suryathanush/GanFET-Buck-Converter/Frimware/images/Status Command.png

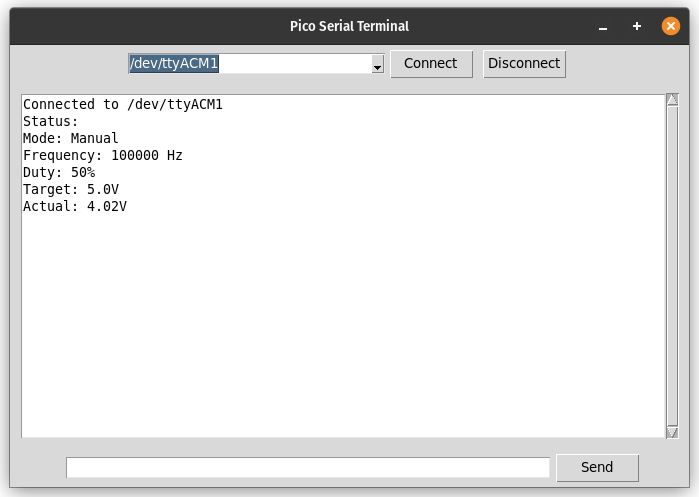
Frimware/images/Status Command.png
