suryathanush/GanFET-Buck-Converter/PCB/snor026/LMG1210 EVM files/HVP012A(001)_BOM.xls

Filename: | HVP012A(001)_BOM.xls
Variant: | 001
Generated: | 6/4/2018 12:50:12 PM
 |  | LMG1210EVM-012
Designator | Quantity | Value | Description | PackageReference | PartNumber | Manufacturer | Alternate PartNumber | Alternate Manufacturer
!PCB1 | 1 |  | Printed Circuit Board |  | HVP012 | Any
C1, C11 | 2 | 10uF | CAP, CERM, 10 uF, 25 V, +/- 10%, X7R, 1206 | 1206 | 885012208069 | Wurth Elektronik
C2, C14 | 2 | 0.47uF | Feedthru Capacitor, 0.47uF, 6.3V, SMD | 0603 | YFF18PW0J474M | TDK
C3, C19 | 2 | 1uF | CAP, CERM, 1 uF, 250 V, +/- 10%, X7R, 2220 | 2220 | GRM55DR72E105KW01L | MuRata
C4, C5, C12 | 3 | 0.022uF | CAP, CERM, 0.022 uF, 250 V, +/- 10%, X7R, 0805 | 0805 | QMK212B7223KG-T | Taiyo Yuden
C7, C10, C18, C21 | 4 | 0.22uF | CAP, CERM, 0.22 uF, 250 V, +/- 10%, X7R, 1210 | 1210 | GRM32DR72E224KW01L | MuRata
C13 | 1 | 0.1uF | CAP, CERM, 0.1 uF, 25 V, +/- 10%, X7R, 0603 | 0603 | GRM188R71E104KA01D | MuRata
D1 | 1 | 100V | Diode, Schottky, 100 V, 0.25 A, SOD-323F | SOD-323F | BAT46WJ,115 | Nexperia
D2, D3 | 2 | Green | LED, Green, SMD | LED_0805 | LTST-C170KGKT | Lite-On
H1, H2, H3, H4 | 4 |  | Machine Screw, Round, #4-40 x 1/4, Nylon, Philips panhead | Screw | NY PMS 440 0025 PH | B&F Fastener Supply
H5, H6, H7, H8 | 4 |  | Standoff, Hex, 0.5"L #4-40 Nylon | Standoff | 1902C | Keystone
J1 | 1 |  | Terminal Block, 2.54mm, 2x1, Brass, TH | Terminal Block, 2.54mm, 2-pole, Brass, TH | OSTVN02A150 | On-Shore Technology
J2, J5 | 2 |  | Terminal Block, 2x1, 5.08mm, TH | 10.16x15.2x9mm | 282841-2 | TE Connectivity
J3, J6, J7 | 3 |  | Header, 2.54 mm, 2x1, Gold, TH | Header, 2.54 mm, 2x1, TH | GBC02SAAN | Sullins Connector Solutions
J4 | 1 |  | Header, 100mil, 4x1, Tin, TH | Header, 4x1, 100mil, TH | 5-146278-4 | TE Connectivity
L2 | 1 | 4.7uH | Inductor, Shielded, Composite, 4.7 uH, 10.5 A, 0.00889 ohm, SMD | 8.1 x 8 x 8.6mm | XAL8080-472ME | Coilcraft
Q1, Q2 | 2 | 100V | MOSFET, N-CH, 100 V, 36 A, 4.105x1.632mm | 4.105x1.632mm | EPC2001C | EPC |  | None
R2, R4 | 2 | 0 | RES, 0, 5%, 0.1 W, AEC-Q200 Grade 0, 0402 | 0402 | ERJ-2GE0R00X | Panasonic
R3, R10 | 2 | 0 | RES, 0, 5%, 0.05 W, AEC-Q200 Grade 1, 0201 | 0201 | ERJ-1GE0R00C | Panasonic
R6, R9 | 2 | 20.0k | RES, 20.0 k, 1%, 0.063 W, AEC-Q200 Grade 0, 0402 | 0402 | CRCW040220K0FKED | Vishay-Dale
R7 | 1 | 0.005 | RES, 0.005, 1%, 1 W, 0612 | 0612 | PRL1632-R005-F-T1 | Susumu Co Ltd
R11, R12 | 2 | 20.0k | RES, 20.0 k, 1%, 0.05 W, 0201 | 0201 | CRCW020120K0FKED | Vishay-Dale
R13, R14 | 2 | 1M | TRIMMER 1M OHM 0.25W SMD | 3.5x5.3x4.8mm | 3224X-1-105E | Bourns
R15 | 1 | 1.0k | RES, 1.0 k, 5%, 0.1 W, AEC-Q200 Grade 0, 0603 | 0603 | CRCW06031K00JNEA | Vishay-Dale
R16 | 1 | 100k | RES, 100 k, 5%, 0.25 W, AEC-Q200 Grade 0, 1206 | 1206 | CRCW1206100KJNEA | Vishay-Dale
SH-J1 | 1 | 1x2 | Shunt, 100mil, Gold plated, Black | Shunt | SNT-100-BK-G | Samtec | 969102-0000-DA | 3M
TP1 | 1 |  | Test Point, Compact, Yellow, TH | Yellow Compact Testpoint | 5009 | Keystone
TP2 | 1 |  | Test Point, Compact, Red, TH | Red Compact Testpoint | 5005 | Keystone
TP4, TP7, TP13 | 3 |  | Test Point, Compact, Black, TH | Black Compact Testpoint | 5006 | Keystone
TP6, TP10 | 2 |  | Test Point, Miniature, Red, TH | Red Miniature Testpoint | 5000 | Keystone
U1 | 1 |  | Advanced eGaN FET 300V Half-bridge Drive, RVR0019A (WQFN-19) | RVR0019A | LMG1210RVR | Texas Instruments |  | Texas Instruments
U2 | 1 |  | Dual Schmitt-Trigger Buffer, DBV0006A, LARGE T&R | DBV0006A |  | Texas Instruments
C6 | 0 | 22uF | CAP, AL, 22 uF, 20 V, +/- 20%, 0.06 ohm, SMD | F60 | APXH200ARA220MF60G | Chemi-Con
C15, C16 | 0 | 10pF | CAP, CERM, 10 pF, 50 V, +/- 5%, C0G/NP0, 0402 | 0402 | 500R07S100JV4T | Johanson Technology
C17 | 0 | 47uF | CAP, AL, 47 uF, 20 V, +/- 20%, 0.045 ohm, SMD | H70 | APXH200ARA470MH70G | Chemi-Con
C20 | 0 | 0.22uF | CAP, CERM, 0.22 uF, 250 V, +/- 10%, X7R, 1210 | 1210 | GRM32DR72E224KW01L | MuRata
FID1, FID2, FID3, FID4, FID5, FID6 | 0 |  | Fiducial mark. There is nothing to buy or mount. | N/A | N/A | N/A
R1, R8 | 0 | 0 | RES, 0, 5%, 0.1 W, AEC-Q200 Grade 0, 0402 | 0402 | ERJ-2GE0R00X | Panasonic
SH-J1 | 1 |  | Shunt, 100mil, Gold plated, Black | Shunt | SNT-100-BK-G | Samtec
 |  | Notes:
 |  | Unless otherwise noted in the Alternate PartNumber and/or Alternate Manufacturer columns, all parts may be substituted with equivalents.
