suryathanush/GanFET-Buck-Converter/PCB/LIB_YFF18PW0J474MT0H0N/YFF18PW0J474MT0H0N.stp

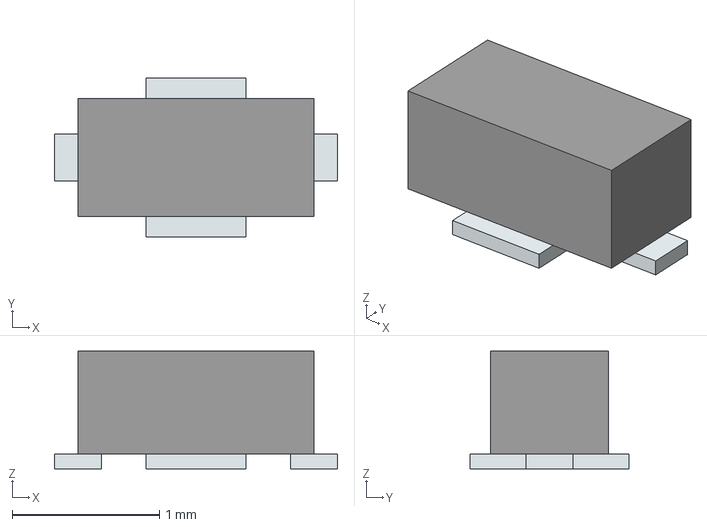
[picture p7: CAD file, 2025-04-16]
PCB/LIB_YFF18PW0J474MT0H0N/YFF18PW0J474MT0H0N.stp
1.92 x 1.08 x 0.8 mm
Pins
