suryathanush/GanFET-Buck-Converter/PCB/snor026/LMG1210 EVM files/HVP012A(001)_Sch.PDF

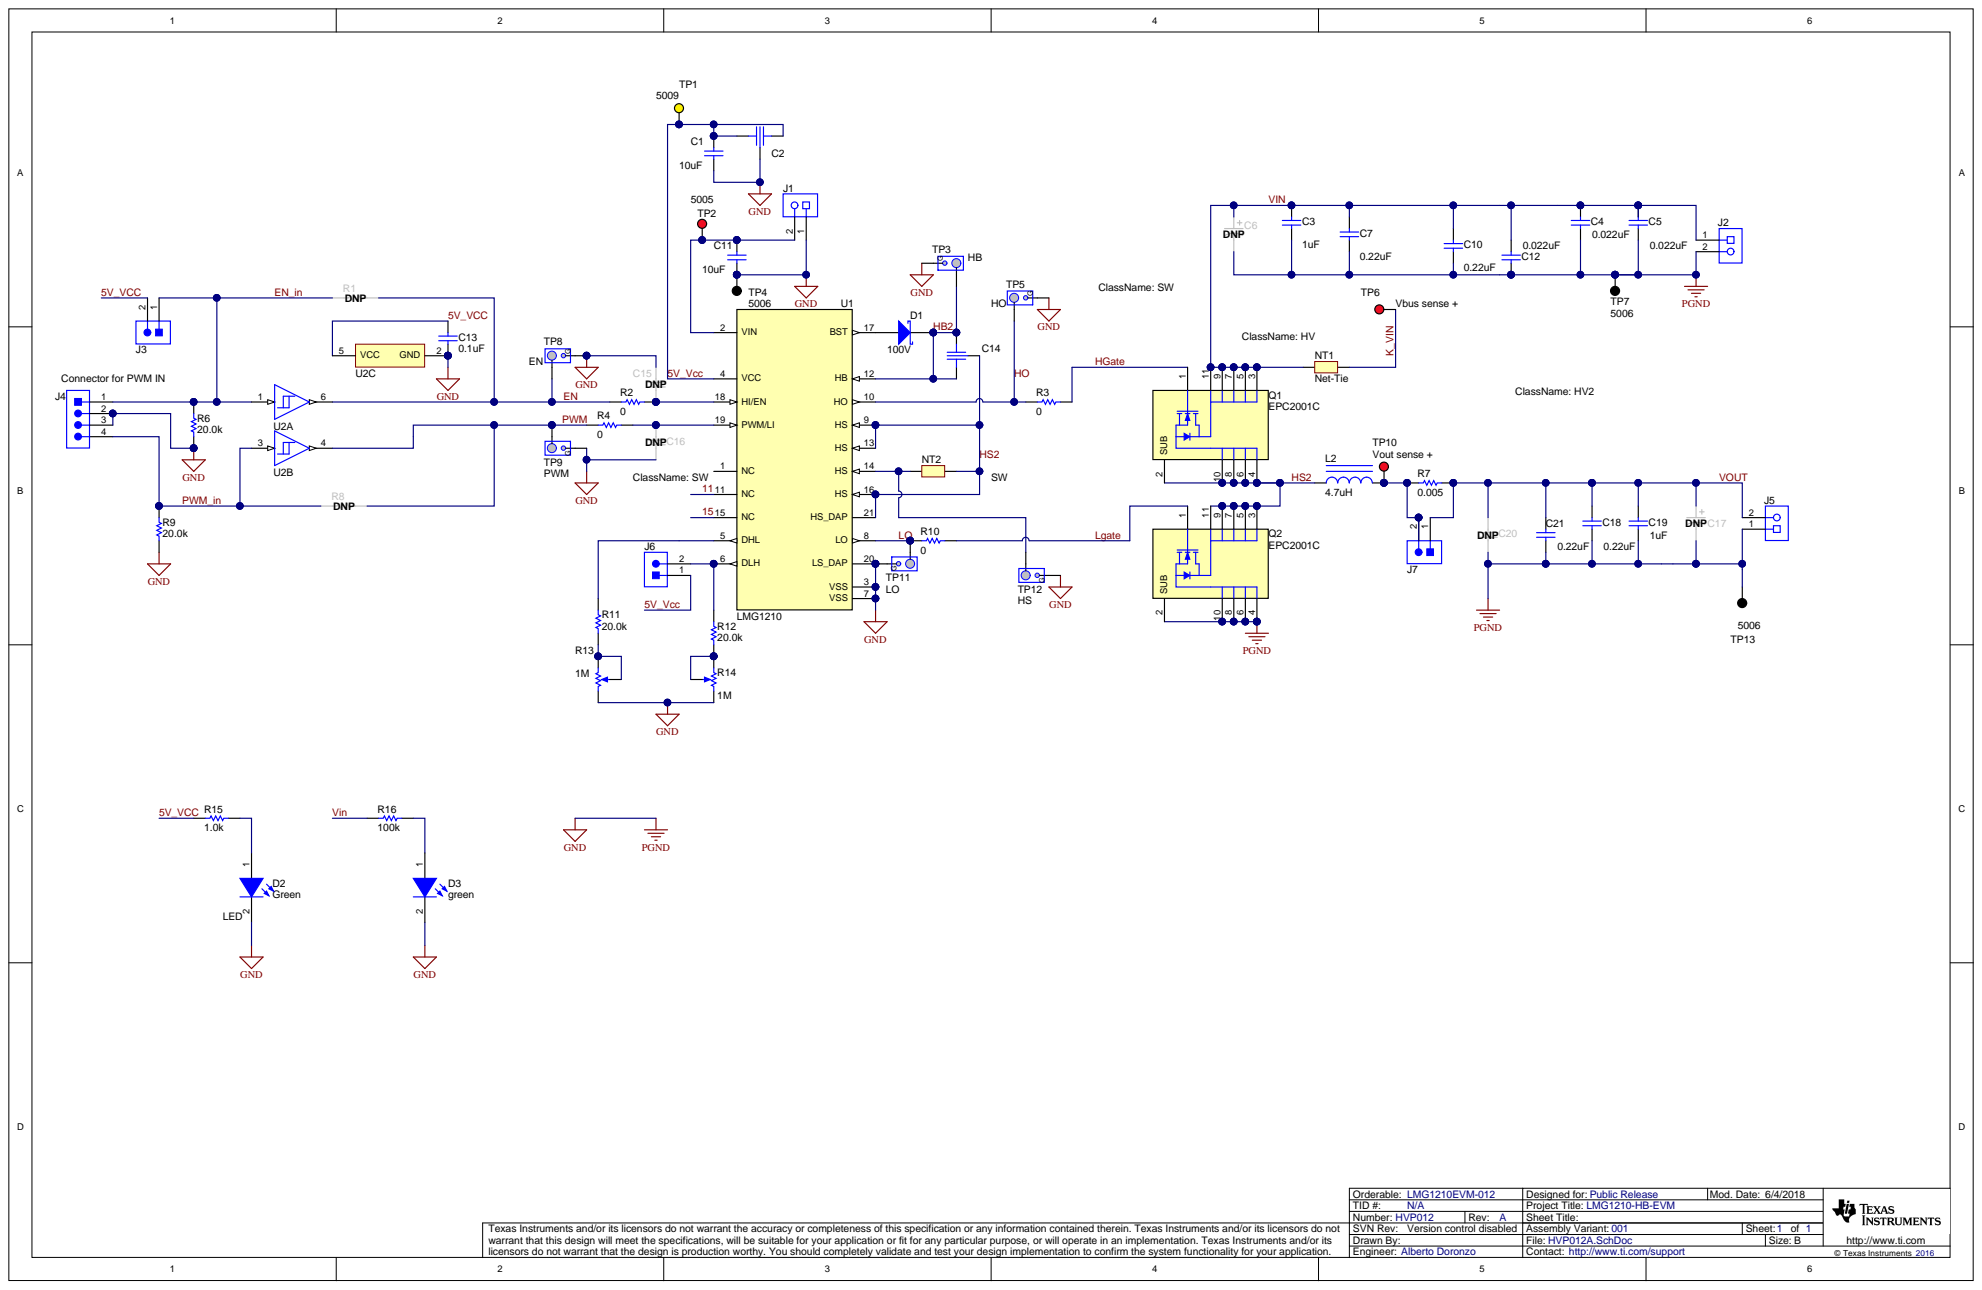
[picture p11: page 1]

C1 10uF 5005 TP2 5V_Vcc

Connector for PWM IN

Orderable: LMG1210EVM-012 | Designed for: Public Release | Mod. Date: 6/4/2018 | http://www.ti.com
TID #: N/A | Project Title: LMG1210-HB-EVM
Number: HVP012 | Rev: A | Sheet Title:
SVN Rev: Version control disabled | Assembly Variant: 001 | Sheet: 1 of 1
Drawn By: | File: HVP012A.SchDoc | Size: B

Texas Instruments and/or its licensors do not warrant the accuracy or completeness of this specification or any information contained therein. Texas Instruments and/or its licensors do not
warrant that this design will meet the specifications, will be suitable for your application or fit for any particular purpose, or will operate in an implementation. Texas Instruments and/or its
licensors do not warrant that the design is production worthy. You should completely validate and test your design implementation to confirm the system functionality for your application.

Contact: http://www.ti.com/support © Texas Instruments 2016

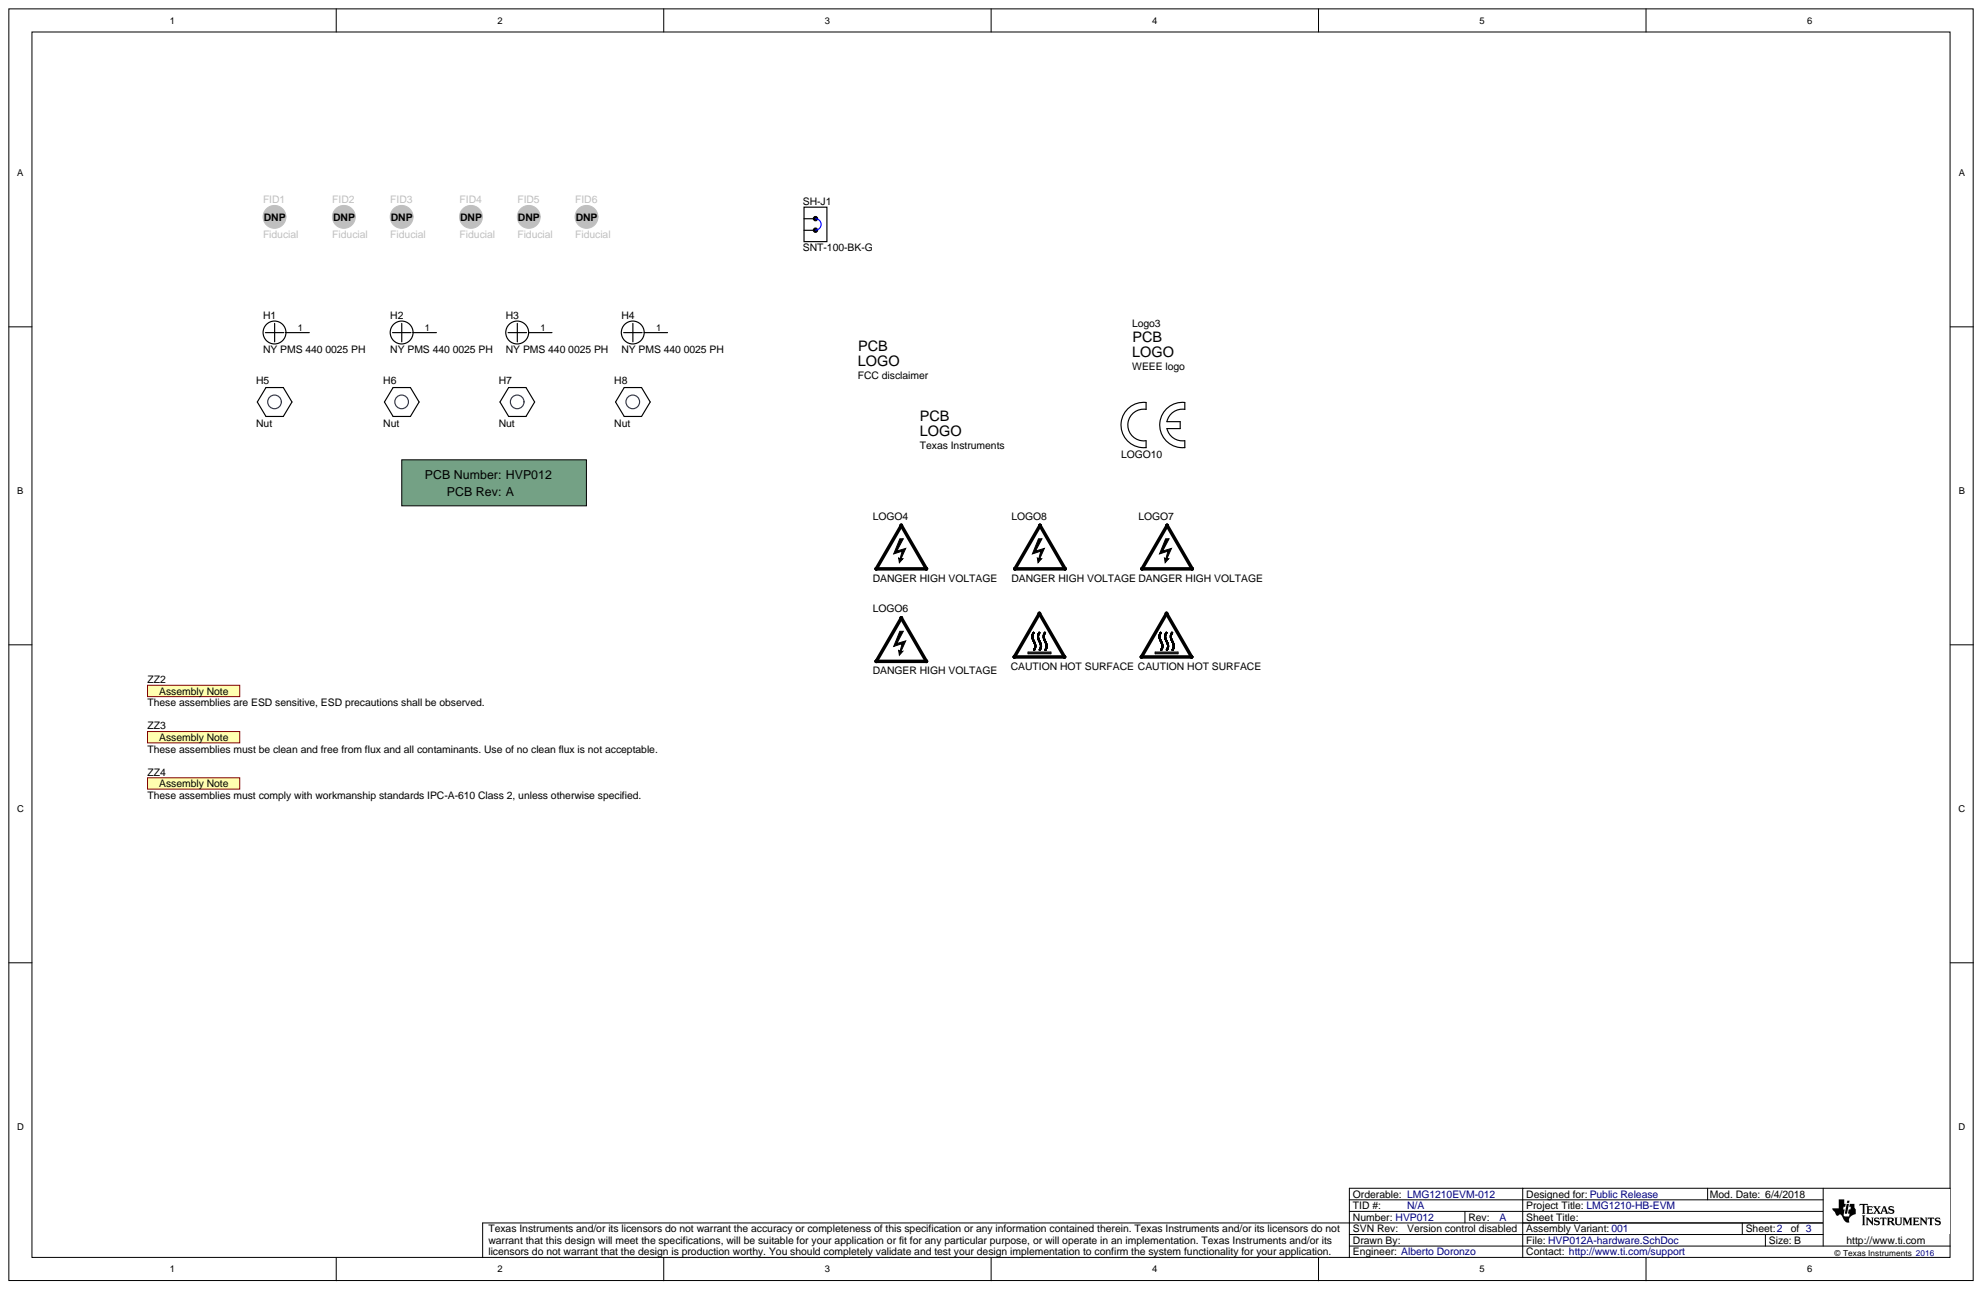
[picture p12: page 2]

Assembly Note
These assemblies are ESD sensitive, ESD precautions shall be observed.

These assemblies must be clean and free from flux and all contaminants. Use of no clean flux is not acceptable.

These assemblies must comply with workmanship standards IPC-A-610 Class 2, unless otherwise specified.

Orderable: LMG1210EVM-012 | Designed for: Public Release | Mod. Date: 6/4/2018 | http://www.ti.com
TID #: N/A | Project Title: LMG1210-HB-EVM
Number: HVP012 | Rev: A | Sheet Title:
SVN Rev: Version control disabled | Assembly Variant: 001 | Sheet: 2 of 3
Drawn By: | File: HVP012A-hardware.SchDoc | Size: B

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

Contact: http://www.ti.com/support © Texas Instruments 2016
