suryathanush/GanFET-Buck-Converter/PCB/Schematic_21_04_2025.pdf

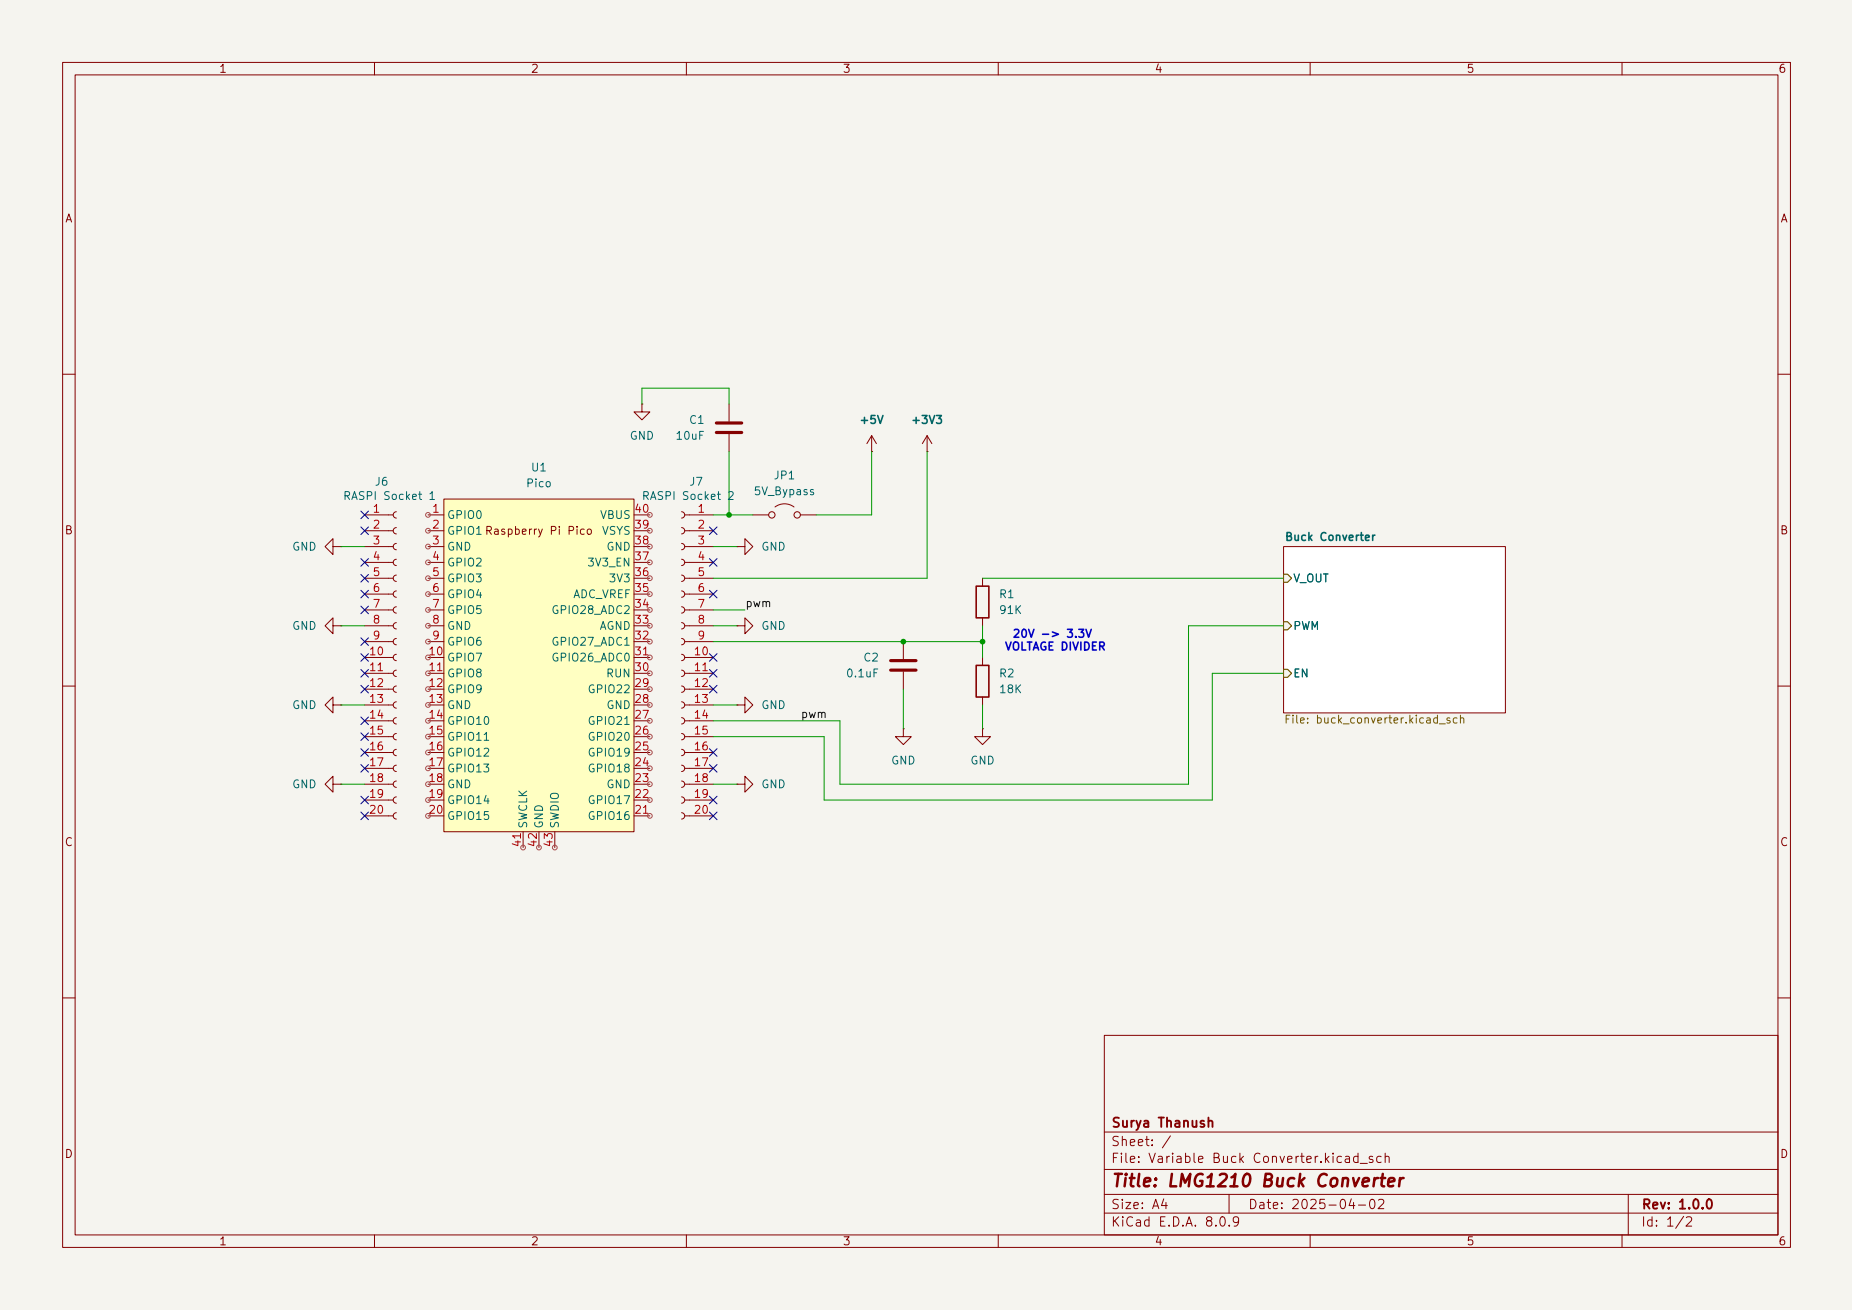
[picture p13: page 1]

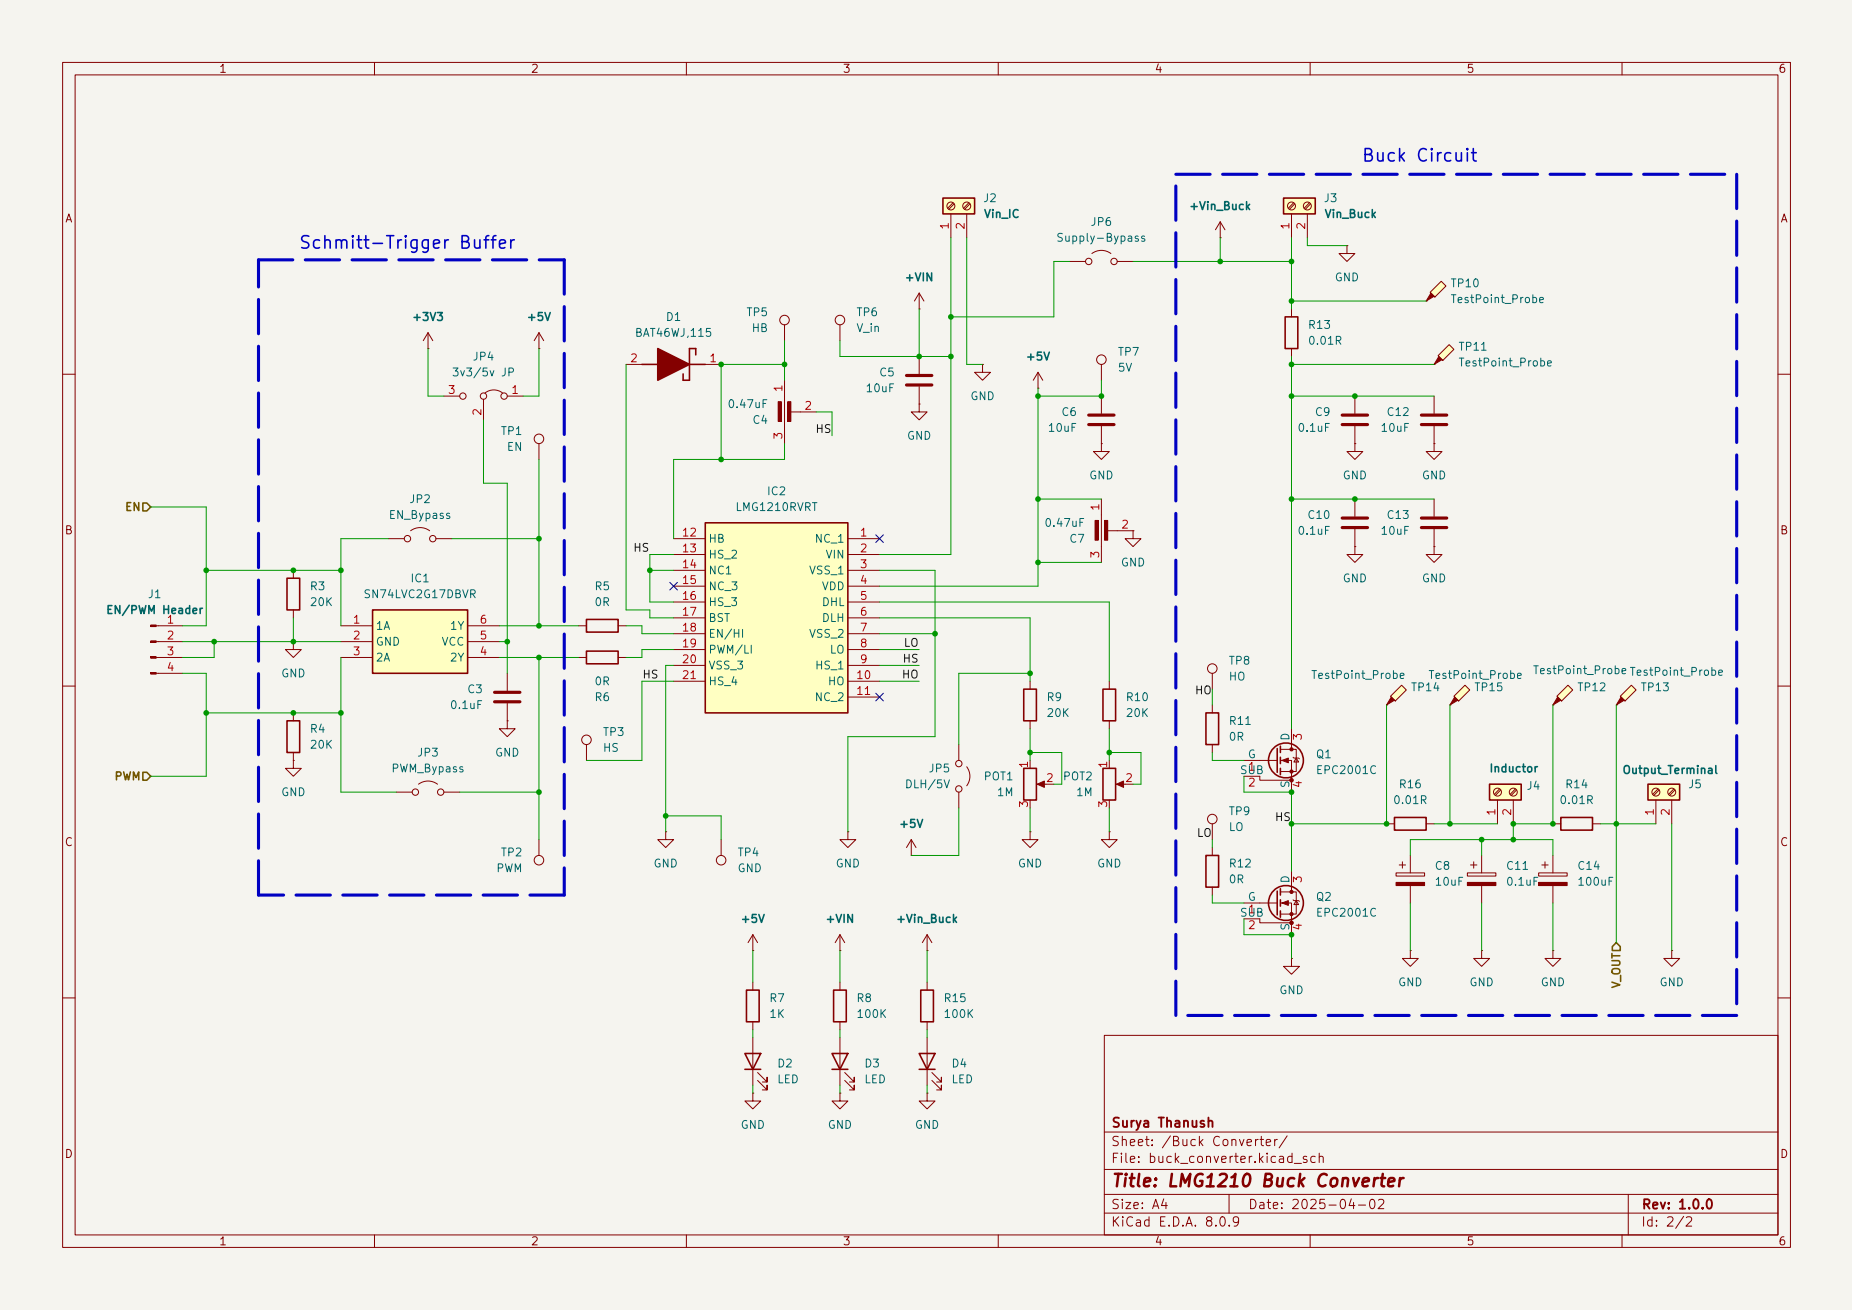
[picture p14: page 2]
