suryathanush/GanFET-Buck-Converter/PCB/snor026/LMG1210 EVM files/HVP012A(001)_Assy.PDF

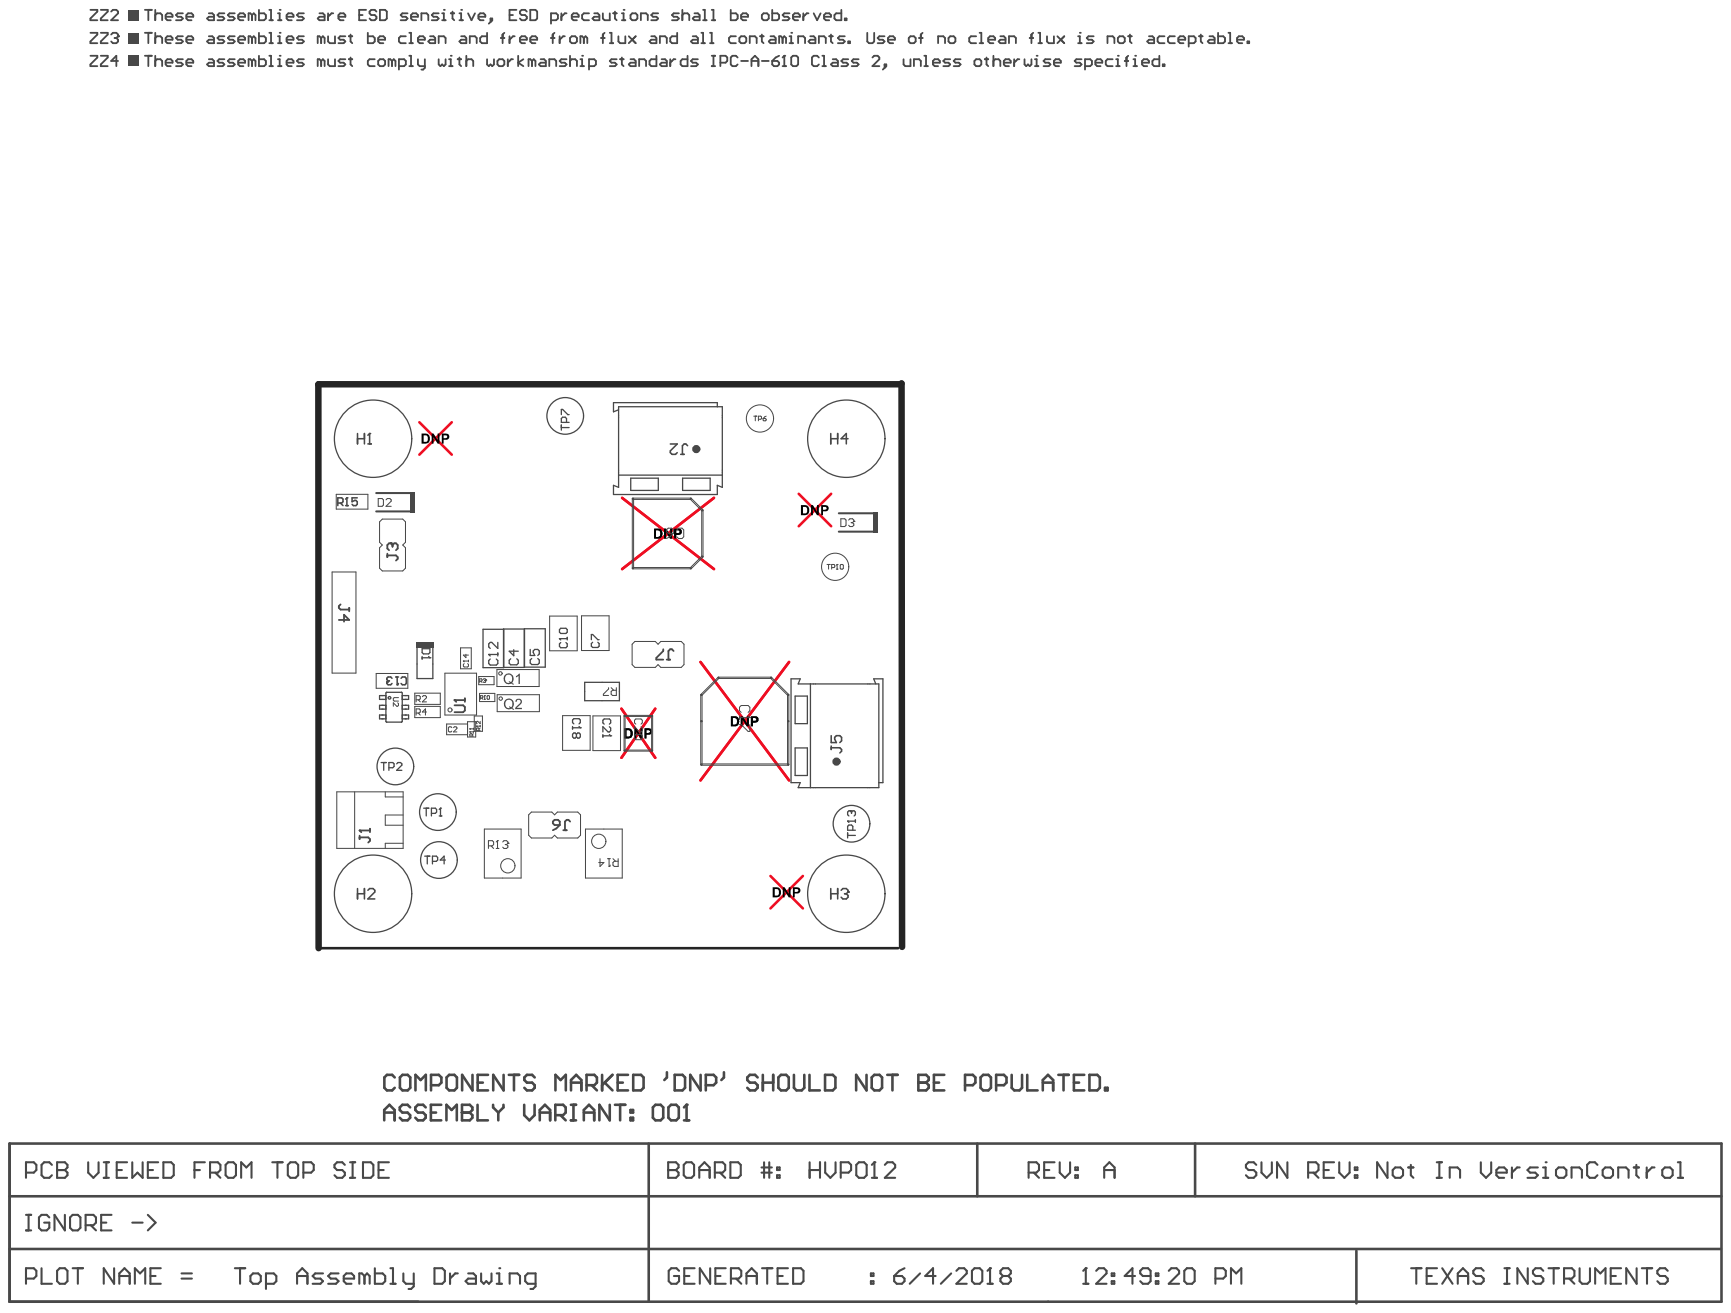
[picture p15: page 1]

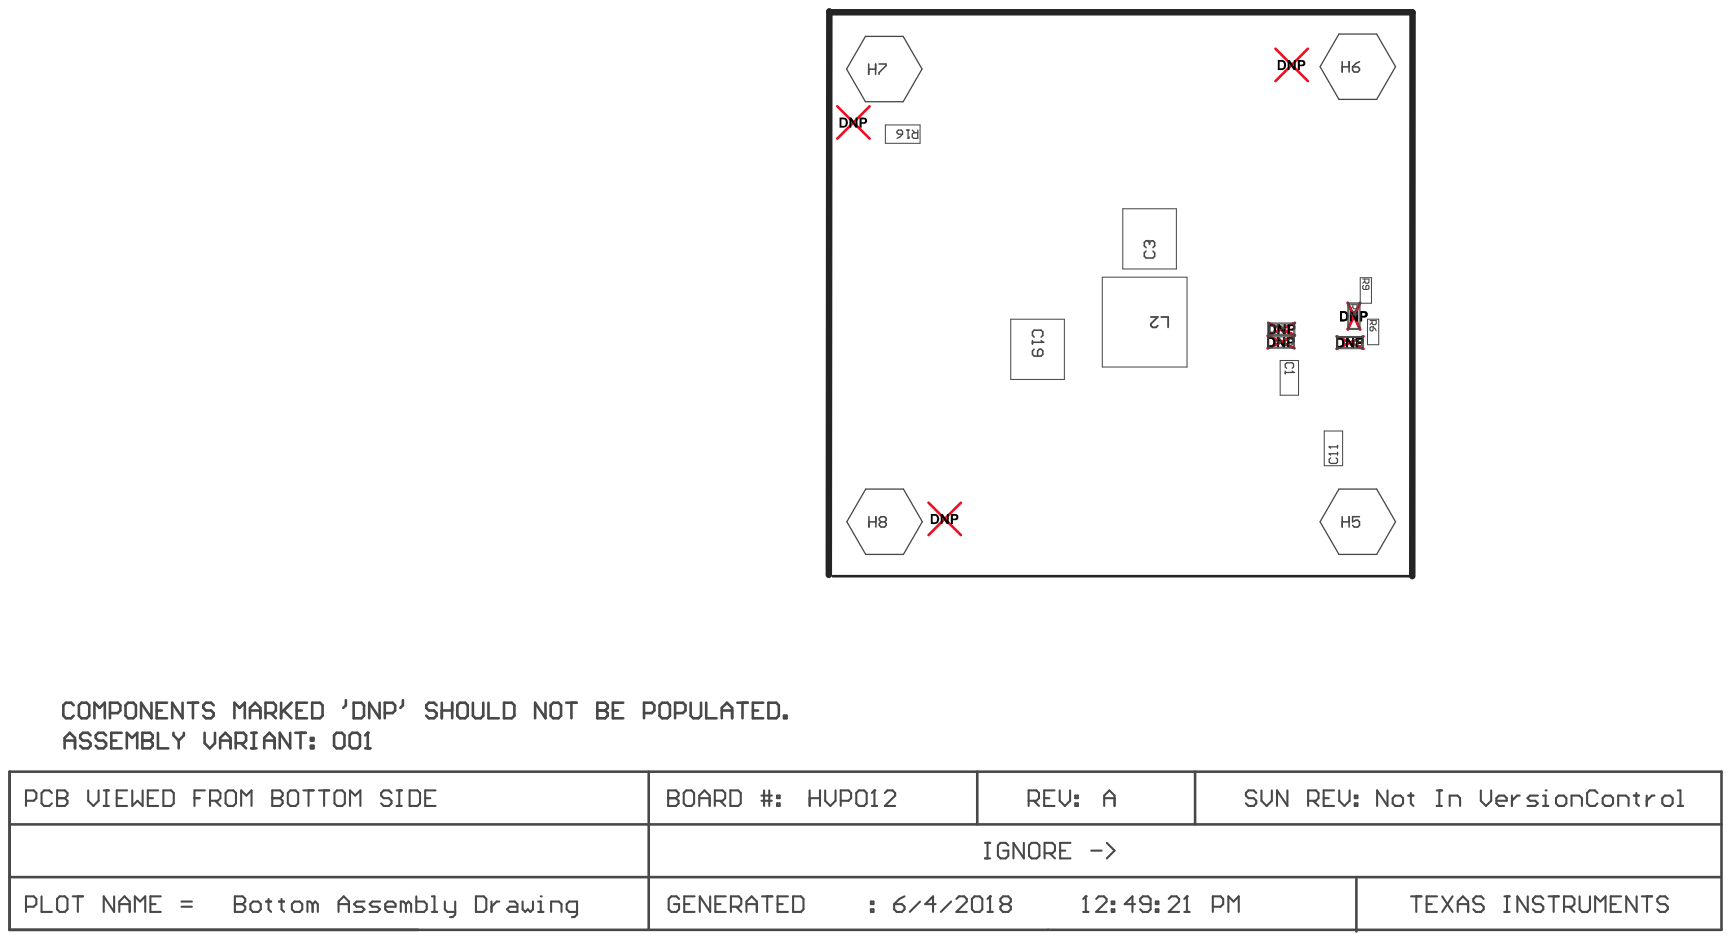
[picture p16: page 2]
