suryathanush/GanFET-Buck-Converter/PCB/snor026/LMG1210 EVM files/HVP012A_FabNotes.PDF

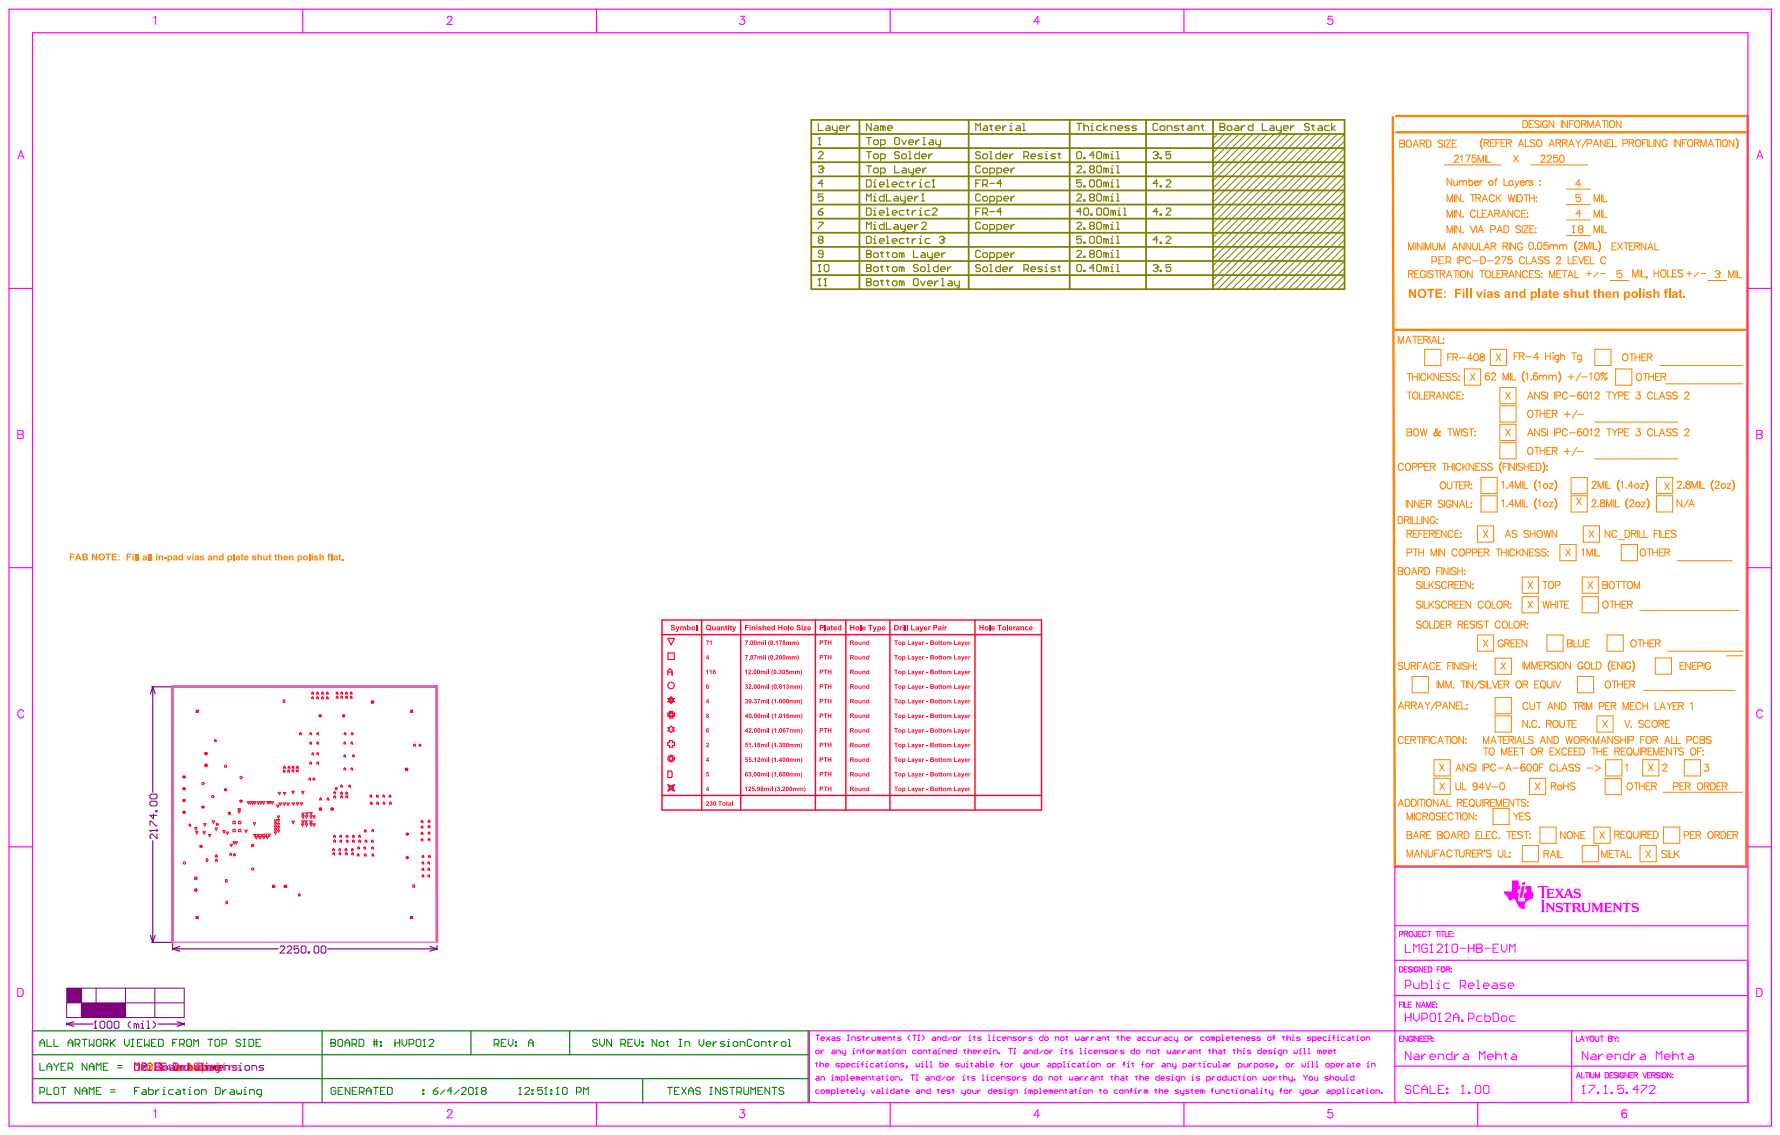
[picture p17: page 1]
