suryathanush/GanFET-Buck-Converter/(list of files, drawings)

Other design files:
PCB/snor026/LMG1210 EVM files/altium viewer/HVP012A.PcbDoc
PCB/snor026/LMG1210 EVM files/altium viewer/HVP012A.PrjPcb
PCB/snor026/LMG1210 EVM files/altium viewer/HVP012A.SchDoc
PCB/snor026/LMG1210 EVM files/altium viewer/HVP012A.SCHLIB
PCB/snor026/LMG1210 EVM files/HVP012A.PcbDoc
PCB/snor026/LMG1210 EVM files/HVP012A.PrjPcb
PCB/snor026/LMG1210 EVM files/HVP012A.SchDoc
PCB/snor026/LMG1210 EVM files/HVP012A.SCHLIB
