suryathanush/GanFET-Buck-Converter/PCB/Variable Buck Converter.kicad_pcb

## KiCad design PCB/Variable Buck Converter.kicad_pcb (2025-04-21)

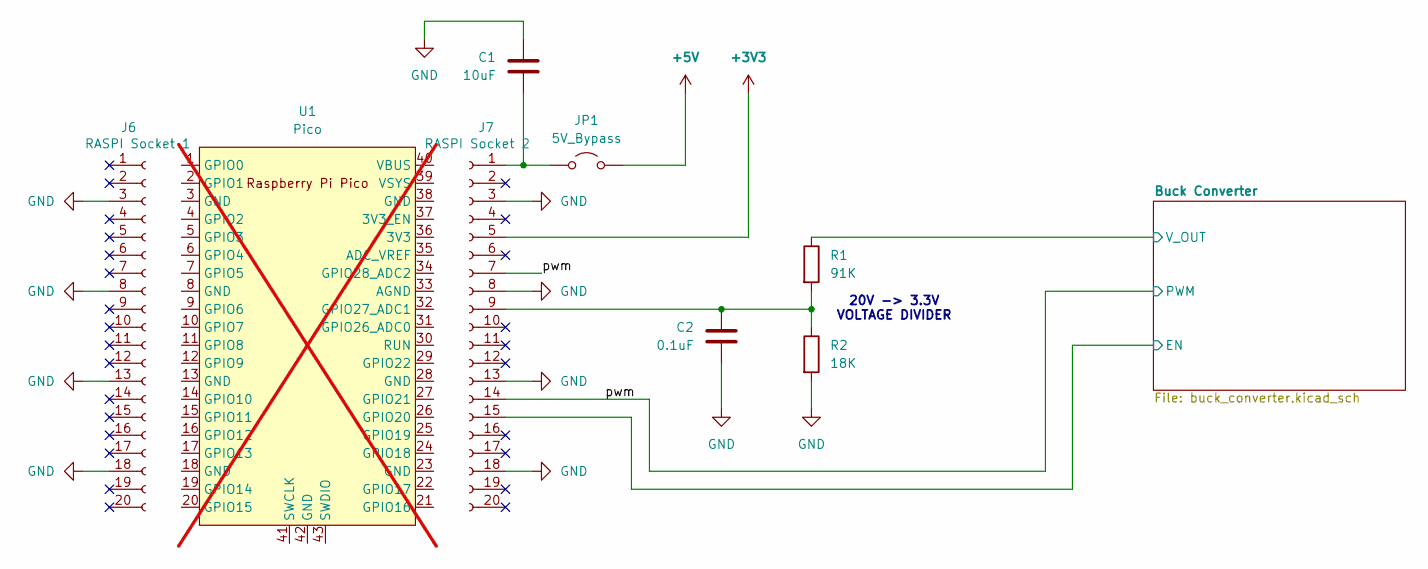
[picture p28: schematic Variable Buck Converter.kicad_sch, LMG1210 Buck Converter]

Parts:
C1: 10uF; C_0603_1608Metric; Manufacturer_Part_Number CL10A106MA8NRNC
C2: 0.1uF; C_0603_1608Metric; Manufacturer_Part_Number CL10B104JB8NNND
J6: RASPI Socket 1; PinSocket_1x20_P2.54mm_Vertical; Manufacturer_Part_Number PH1-20-UA
J7: RASPI Socket 2; PinSocket_1x20_P2.54mm_Vertical; Manufacturer_Part_Number PH1-20-UA
JP1: 5V_Bypass; PinHeader_1x02_P2.54mm_Vertical; Manufacturer_Part_Number HTSW-102-07-T-S
R1: 91K; R_0603_1608Metric; Manufacturer_Part_Number RT0603BRD0791KL
R2: 18K; R_0603_1608Metric; Manufacturer_Part_Number RT0603BRD0718KL
U1: Pico; RPi_Pico_SMD_TH; not fitted

Connections:
+3V3: J7.5; also elsewhere on the board
+5V: JP1.2 (B); also elsewhere on the board
/Buck Converter/EN: J7.15; also elsewhere on the board
/Buck Converter/V_OUT: R1.1; also elsewhere on the board
/pwm: J7.7, J7.14; also elsewhere on the board
GND: C1.1, C2.2, J6.3, J6.8, J6.13, J6.18, J7.3, J7.8, J7.13, J7.18, R2.2; also elsewhere on the board
unnamed: C1.2, J7.1, JP1.1 (A)
unnamed: C2.1, J7.9, R1.2, R2.1

Notes on the sheet:
20V -> 3.3V VOLTAGE DIVIDER

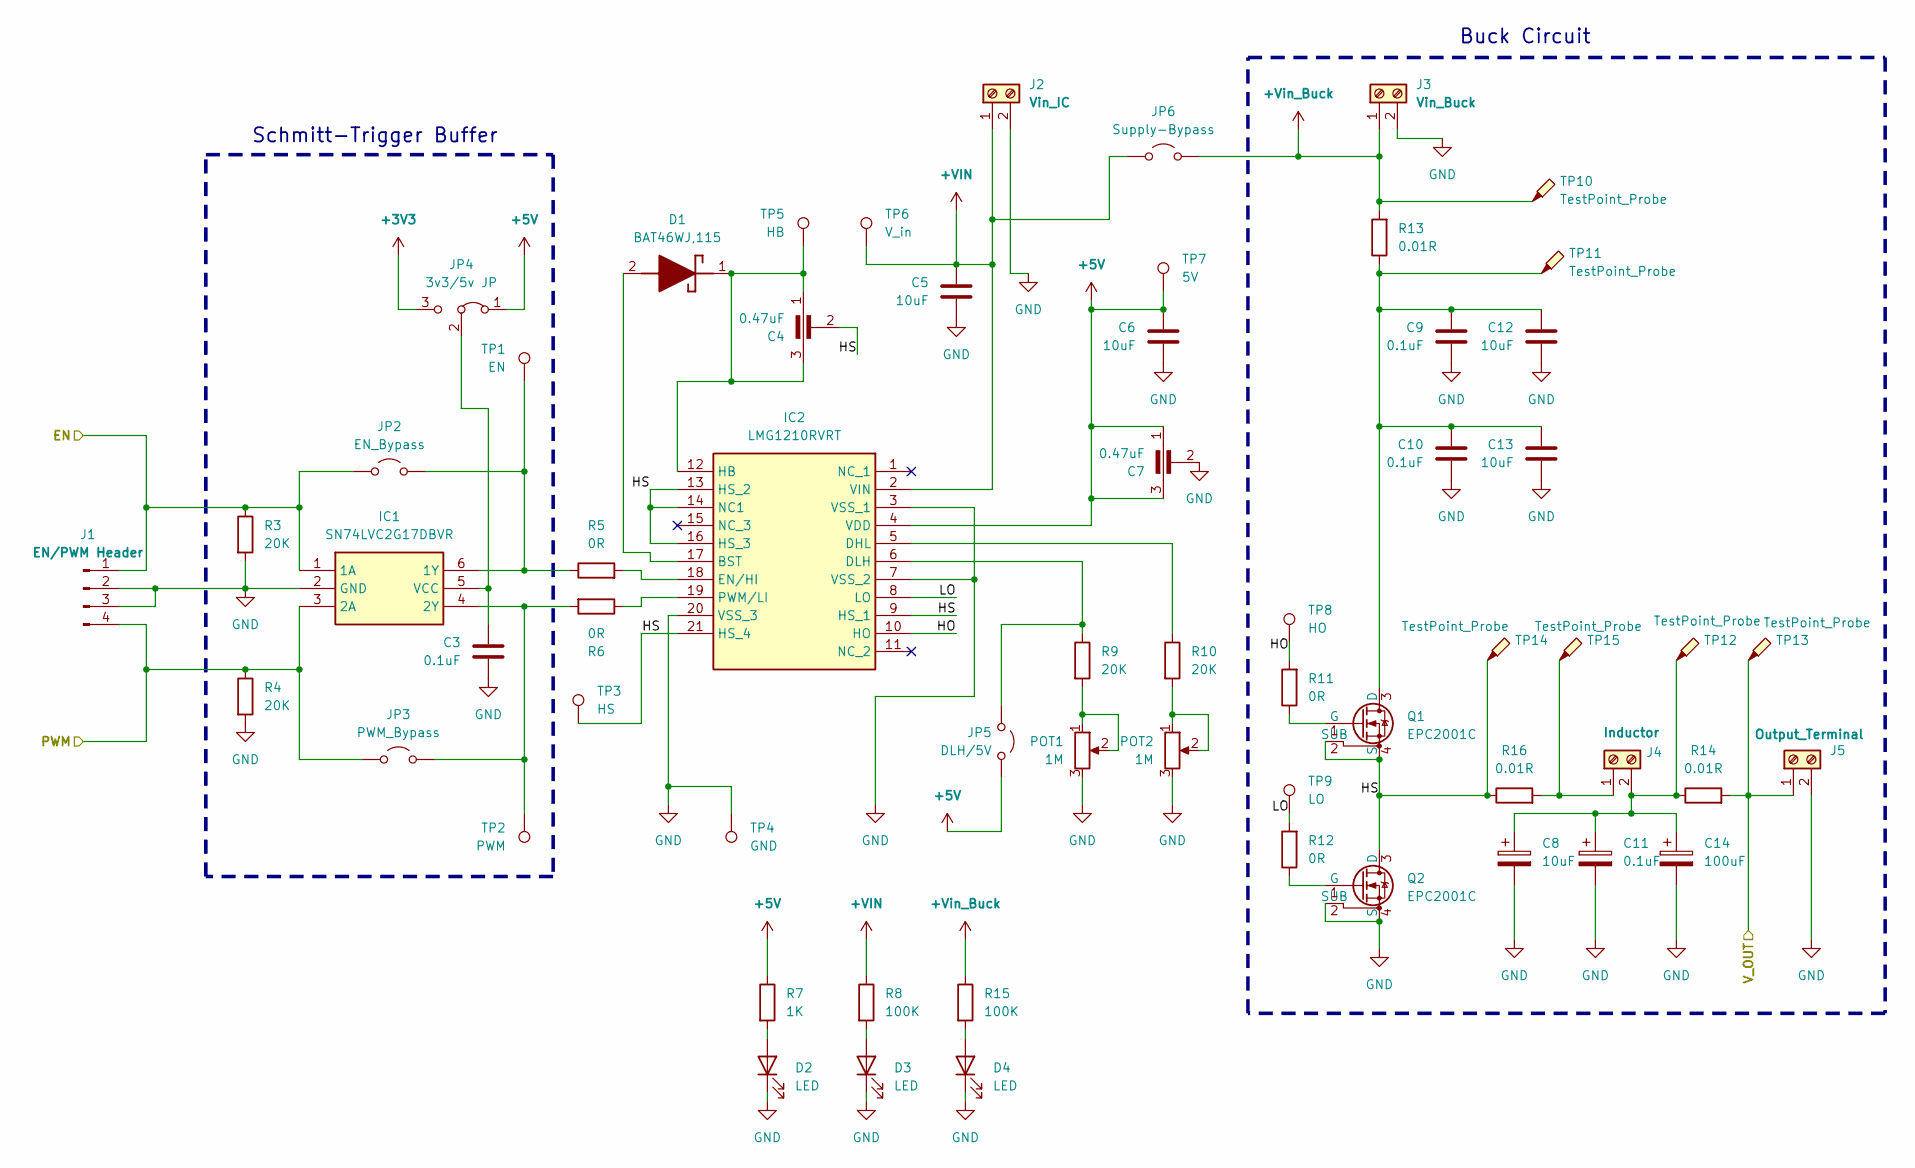
[picture p29: schematic buck_converter.kicad_sch, LMG1210 Buck Converter]

Parts:
C3, C9, C10, C11: 0.1uF; C_0603_1608Metric; Manufacturer_Part_Number CL10B104JB8NNND
C4, C7: 0.47uF; YFF18PW0J474MT0H0N; Manufacturer_Part_Number YFF18PW0J474MT0H0N
C5, C6, C8, C12, C13: 10uF; C_0603_1608Metric; Manufacturer_Part_Number CL10A106MA8NRNC
C14: 100uF; CP_Elec_6.3x5.9; Manufacturer_Part_Number 865080545012
D1: BAT46WJ,115; SODFL2512X80N; Manufacturer_Part_Number BAT46WJ,115; Mouser Part Number 771-BAT46WJ115
D2, D3, D4: LED; LED_0603_1608Metric; Manufacturer_Part_Number LTST-C190GKT
IC1: SN74LVC2G17DBVR; SOT95P280X145-6N; Manufacturer_Part_Number SN74LVC2G17DBVR; Mouser Part Number 595-SN74LVC2G17DBVR
IC2: LMG1210RVRT; Manufacturer_Part_Number LMG1210RVRT; Mouser Part Number 595-LMG1210RVRT
J1: EN/PWM Header; PinHeader_1x04_P2.54mm_Vertical; Manufacturer_Part_Number PH1-04-UA
J2: Vin_IC; TerminalBlock_Phoenix_MKDS-1,5-2_1x02_P5.00mm_Horizontal; Manufacturer_Part_Number 1548128
J3: Vin_Buck; TerminalBlock_Phoenix_MKDS-1,5-2_1x02_P5.00mm_Horizontal; Manufacturer_Part_Number 1548128
J4: Inductor; TerminalBlock_Phoenix_MKDS-1,5-2_1x02_P5.00mm_Horizontal; Manufacturer_Part_Number 1548128
J5: Output_Terminal; TerminalBlock_Phoenix_MKDS-1,5-2_1x02_P5.00mm_Horizontal; Manufacturer_Part_Number 1548128
JP2: EN_Bypass; PinHeader_1x02_P2.54mm_Vertical; Manufacturer_Part_Number HTSW-102-07-T-S
JP3: PWM_Bypass; PinHeader_1x02_P2.54mm_Vertical; Manufacturer_Part_Number HTSW-102-07-T-S
JP4: 3v3/5v JP; PinHeader_1x03_P2.54mm_Vertical; Manufacturer_Part_Number PH1-03-UA
JP5: DLH/5V; PinHeader_1x02_P2.54mm_Vertical; Manufacturer_Part_Number HTSW-102-07-T-S
JP6: Supply-Bypass; PinHeader_1x02_P2.54mm_Vertical; Manufacturer_Part_Number HTSW-102-07-T-S
POT1, POT2: 1M; Potentiometer_Bourns_3296W_Vertical; Manufacturer_Part_Number 3296W-1-105LF
Q1, Q2: EPC2001C; Manufacturer_Part_Number EPC2001C
R3, R4, R9, R10: 20K; R_0603_1608Metric; Manufacturer_Part_Number RT0603FRE0720KL
R5, R6, R11, R12: 0R; R_0603_1608Metric; Manufacturer_Part_Number RCG06030000Z0EA
R7: 1K; R_0603_1608Metric; Manufacturer_Part_Number RT0603FRE131KL
R8, R15: 100K; R_0603_1608Metric; Manufacturer_Part_Number RT0603FRE07100KL
R13, R14, R16: 0.01R; R_1206_3216Metric; Manufacturer_Part_Number PE1206DRM7W0R01L
TP1: EN; TestPoint_Loop_D2.60mm_Drill1.6mm_Beaded; Manufacturer_Part_Number 5278
TP2: PWM; TestPoint_Loop_D2.60mm_Drill1.6mm_Beaded; Manufacturer_Part_Number 5278
TP3: HS; TestPoint_Loop_D2.60mm_Drill1.6mm_Beaded; Manufacturer_Part_Number 5271
TP4: GND; TestPoint_Loop_D2.60mm_Drill1.6mm_Beaded; Manufacturer_Part_Number 5271
TP5: HB; TestPoint_Loop_D2.60mm_Drill1.6mm_Beaded; Manufacturer_Part_Number 5278
TP6: V_in; TestPoint_Loop_D2.60mm_Drill1.6mm_Beaded; Manufacturer_Part_Number 5270
TP7: 5V; TestPoint_Loop_D2.60mm_Drill1.6mm_Beaded; Manufacturer_Part_Number 5270
TP8: HO; TestPoint_Loop_D2.60mm_Drill1.6mm_Beaded; Manufacturer_Part_Number 5273
TP9: LO; TestPoint_Loop_D2.60mm_Drill1.6mm_Beaded; Manufacturer_Part_Number 5273
TP10, TP11: TestPoint_Probe; TestPoint_Loop_D2.60mm_Drill1.6mm_Beaded; Manufacturer_Part_Number 5270
TP12, TP13: TestPoint_Probe; TestPoint_Loop_D2.60mm_Drill1.6mm_Beaded; Manufacturer_Part_Number 5274
TP14, TP15: TestPoint_Probe; TestPoint_Loop_D2.60mm_Drill1.6mm_Beaded; Manufacturer_Part_Number 5277

Connections:
+3V3: JP4.3 (B); also elsewhere on the board
+5V: C6.1, C7.1, C7.3, IC2.4 (VDD), JP4.1 (A), JP5.1 (A), R7.1, TP7.1; also elsewhere on the board
+VIN: C5.1, IC2.2 (VIN), J2.1, JP6.1 (A), R8.1, TP6.1
+Vin_Buck: J3.1, JP6.2 (B), R13.2, R15.1, TP10.1
/Buck Converter/EN: IC1.1 (1A), J1.1, JP2.1 (A), R3.1; also elsewhere on the board
/Buck Converter/HO: IC2.10 (HO), R11.2, TP8.1
/Buck Converter/HS: C4.2, IC2.9 (HS_1), IC2.13 (HS_2), IC2.14 (NC1), IC2.16 (HS_3), IC2.21 (HS_4), Q1.2 (SUB), Q1.4 (S), Q1.6 (S), Q1.8 (S), Q1.10 (S), Q2.3 (D), Q2.5 (D), Q2.7 (D), Q2.9 (D), Q2.11 (D), R16.1, TP3.1, TP14.1
/Buck Converter/LO: IC2.8 (LO), R12.2, TP9.1
/Buck Converter/V_OUT: J5.1, R14.2, TP13.1; also elsewhere on the board
/pwm: IC1.3 (2A), J1.4, JP3.1 (A), R4.1; also elsewhere on the board
GND: C3.2, C5.2, C6.2, C7.2, C8.2, C9.2, C10.2, C11.2, C12.2, C13.2, C14.2, D2.1 (K), D3.1 (K), D4.1 (K), IC1.2 (GND), IC2.3 (VSS_1), IC2.7 (VSS_2), IC2.20 (VSS_3), J1.2, J1.3, J2.2, J3.2, J5.2, POT1.3, POT2.3, Q2.2 (SUB), Q2.4 (S), Q2.6 (S), Q2.8 (S), Q2.10 (S), R3.2, R4.2, TP4.1; also elsewhere on the board
unnamed: C9.1, C10.1, C12.1, C13.1, Q1.3 (D), Q1.5 (D), Q1.7 (D), Q1.9 (D), Q1.11 (D), R13.1, TP11.1
unnamed: D1.2 (A), IC2.17 (BST)
unnamed: C4.1, C4.3, D1.1 (K), IC2.12 (HB), TP5.1
unnamed: D2.2 (A), R7.2
unnamed: D3.2 (A), R8.2
unnamed: D4.2 (A), R15.2
unnamed: IC1.6 (1Y), JP2.2 (B), R5.1, TP1.1
unnamed: IC1.4 (2Y), JP3.2 (B), R6.2, TP2.1
unnamed: C3.1, IC1.5 (VCC), JP4.2 (C)
unnamed: IC2.5 (DHL), R10.1
unnamed: IC2.6 (DLH), JP5.2 (B), R9.1
unnamed: IC2.18 (EN/HI), R5.2
unnamed: IC2.19 (PWM/LI), R6.1
unnamed: J4.1, R16.2, TP15.1
unnamed: C8.1, C11.1, C14.1, J4.2, R14.1, TP12.1
unnamed: POT1.1, POT1.2, R9.2
unnamed: POT2.1, POT2.2, R10.2
unnamed: Q1.1 (G), R11.1
unnamed: Q2.1 (G), R12.1

Notes on the sheet:
Buck Circuit
Schmitt-Trigger Buffer

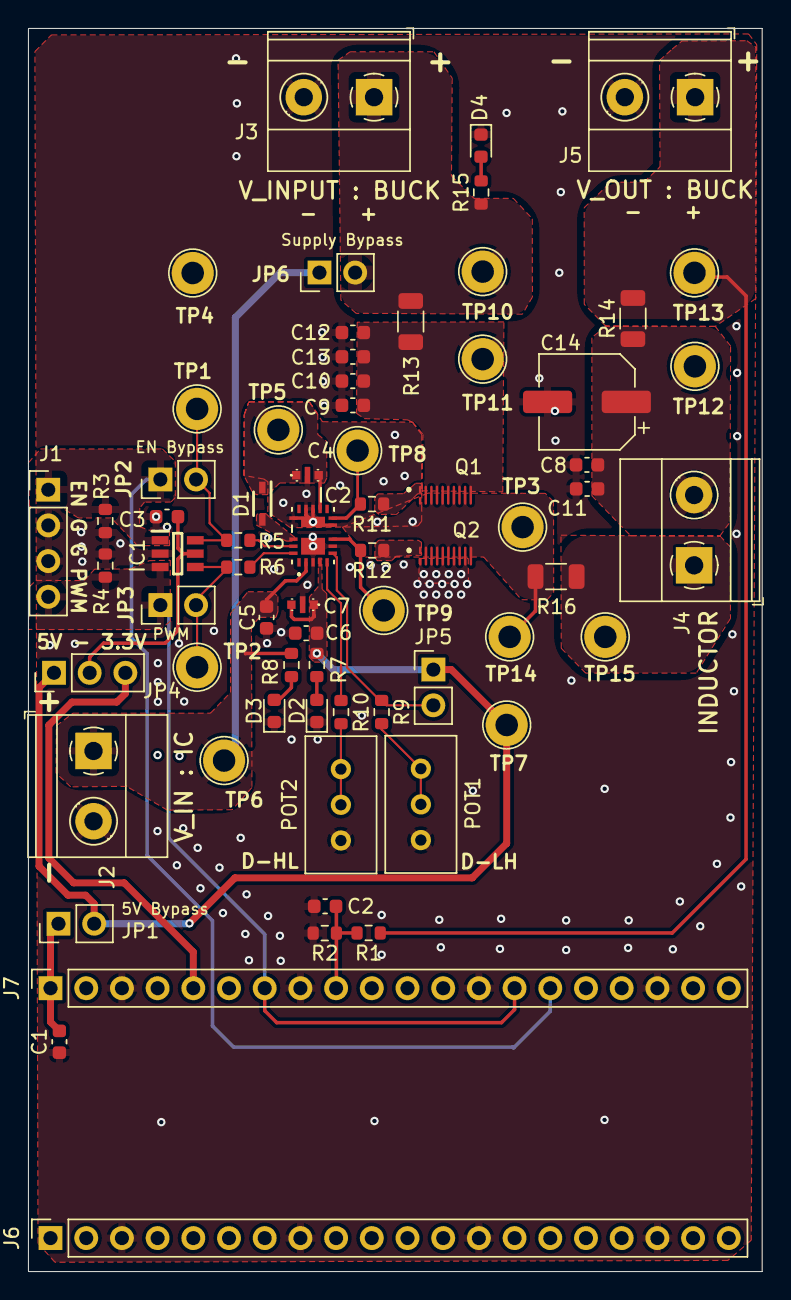
[picture p30: board Variable Buck Converter.kicad_pcb from above]

Board: 4 copper layers, 52.2 x 88.4 mm, 68 parts (0 on the bottom side), 32 nets.
