suryathanush/GanFET-Buck-Converter/(commit log)

2025-04-16 v1.1.0 design
    [BAT46WJ,115.stp, EPC2001C.stp, HVP012A(001)_BOM.xls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]
2025-04-21 v1.1.0 Gerber
    [Variable Buck Converter-B_Cu.gbr, Variable Buck Converter-B_Mask.gbr, Variable Buck Converter-B_Paste.gbr, Variable Buck Converter-B_Silkscreen.gbr, Variable Buck Converter-Edge_Cuts.gbr, Variable Buck Converter-F_Cu.gbr, Variable Buck Converter-F_Mask.gbr, Variable Buck Converter-F_Paste.gbr]
2025-04-21 C14 change, BoM and CPL
    [Variable Buck Converter-B_Cu.gbr, Variable Buck Converter-B_Mask.gbr, Variable Buck Converter-B_Paste.gbr, Variable Buck Converter-B_Silkscreen.gbr, Variable Buck Converter-Edge_Cuts.gbr, Variable Buck Converter-F_Cu.gbr, Variable Buck Converter-F_Mask.gbr, Variable Buck Converter-F_Paste.gbr]
2025-05-31 firmware doc
    [BAT46WJ,115.stp, EPC2001C.stp, HVP012A(001)_BOM.xls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]
